BopItProjectOmega/omega.github.io/README.md

# omega.github.io

Software:
  BopItGame - arduino file used to program the microcontrollor
  
Hardware:
  Beep-It.pcb - PCB design file,
  Beep-It.sch - Sch design file,
  Parts_Bop.txt - BOM file
  
Enclosure:
  Omega.f3d - 3D file
