BopItProjectOmega/omega.github.io/Capture.PNG

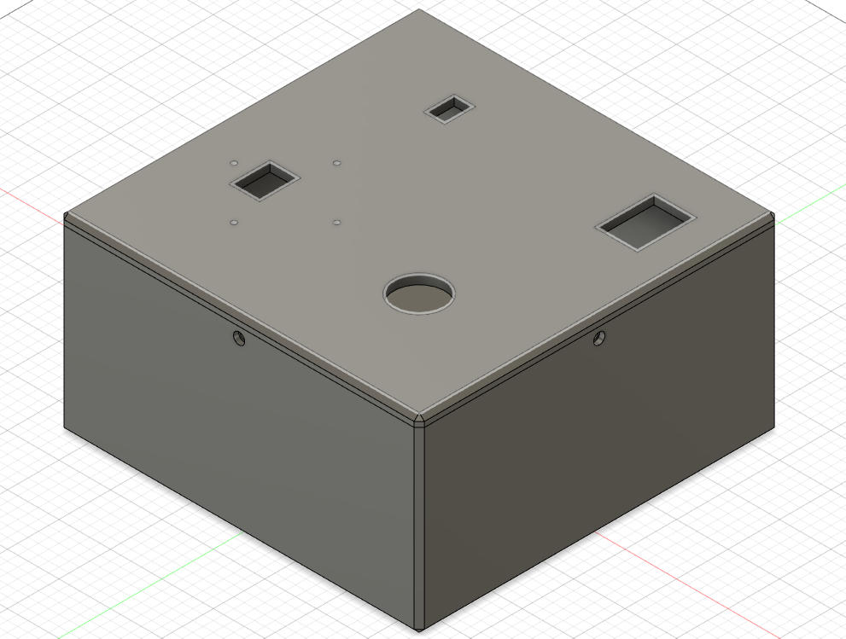
Capture.PNG
