BopItProjectOmega/omega.github.io/SchematicWithoutRegulator.PNG

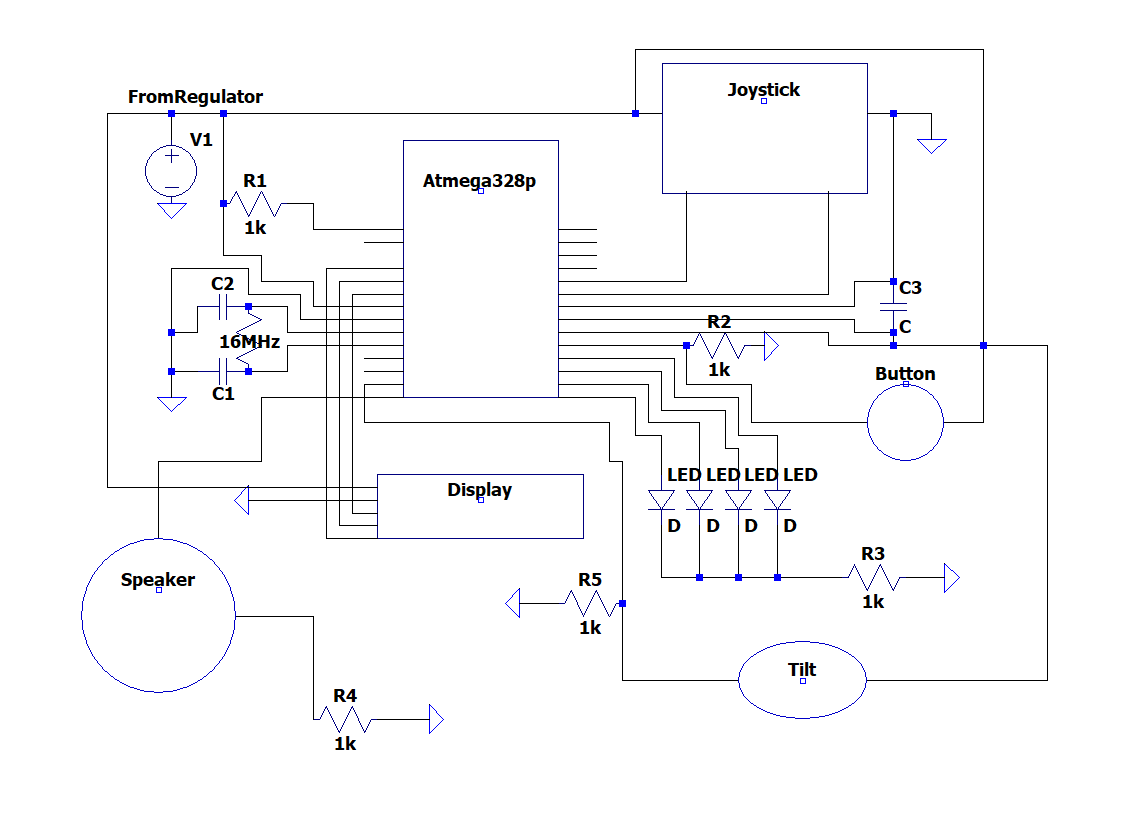
SchematicWithoutRegulator.PNG
