BopItProjectOmega/omega.github.io/base.stl

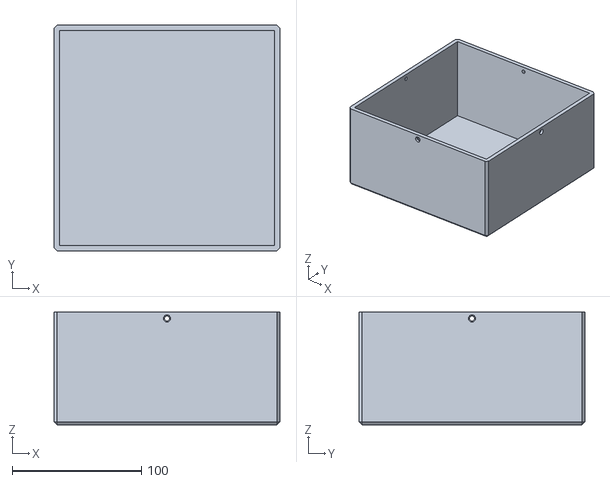
[picture p11: CAD file, 2020-11-28]
base.stl
175.0 x 175.0 x 87.5
