BopItProjectOmega/omega.github.io/lid.stl

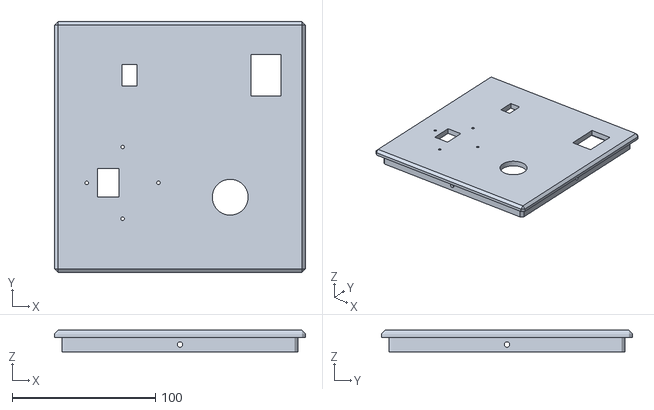
[picture p12: CAD file, 2020-11-28]
lid.stl
175.0 x 175.0 x 15.0
