BopItProjectOmega/omega.github.io/(list of files, cad)

Other CAD files:
Omega.f3d
