BopItProjectOmega/omega.github.io/(list of files, drawings)

Other design files:
Beep-it.PcbDoc
Bop-It.SchDoc
